philcuvin/UHN_N-ARM/UHN N-ARM Capstone Presentation Poster.pdf

Release force of 10 N

Supply 55 L/min flow

Aids in clearing of expiratory CO2

Restricts backflow, ±3% CO2 sensing resolution

Corrugated HEPA Filter

>99.97% filtration efficiency

200 ms response time

Sensor data processing

Up to 100 use cycles

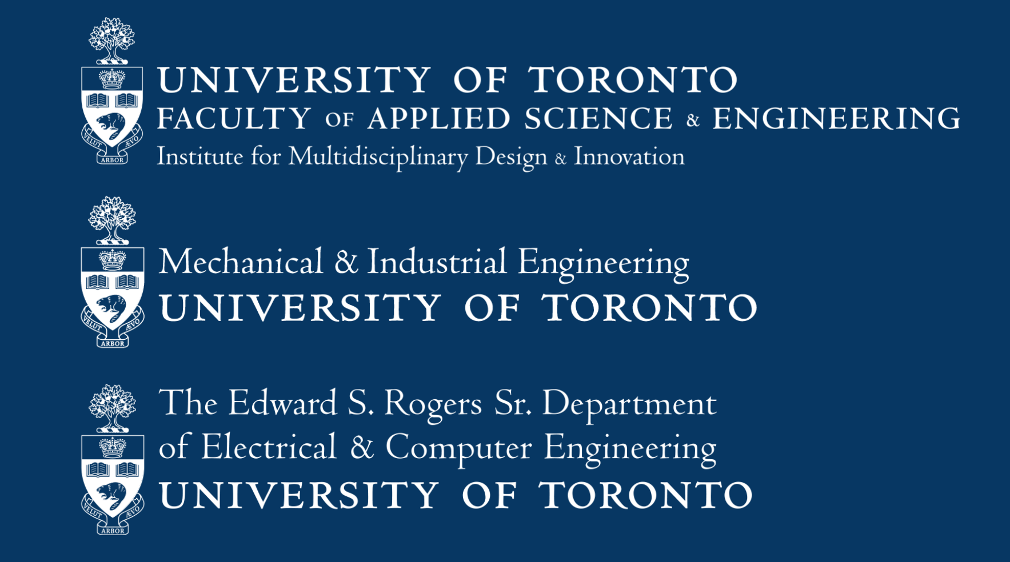
[picture p1: figure]

- Hydro-Guard Mini filter: 1.627 cmH2O at 36.481 L/min
- Simulation: PEEP of 6.258 cmH2O

[4, 5]

This project aims to design a low-cost, open-source, reusable non-invasive ventilation mask and alarm system for patients with respiratory infections.

# The Novel Aerosol-Reducing Mask: A Low-Cost Mask for Non-Invasive Ventilation

## Improvements & Impact References

Problem & Scope | Mask System Design | Testing & Results
- 3.686 cmH2O at 52.367 L/min [3]
- Incorporate a fan with higher static pressure [6]
- Enhanced sealing at the patient interface
- Reduction in size and mass of the electrical system

Resistance to Flow
< 5 cmH2O at
50 L/min

Filter Resistance
≥ 5 cmH2O PEEP at
30 L/min

Silicone Rubber Seal

40 N of sealing force

CO2
Rebreathing
ETCO2

Increase <
20% [3]

Leak Flow Rate
50 mL/min at
10 cmH2O

Polycarbonate Shell

One-Way Valve and CO2

Sensor Port

Noctua NF-A4x10 Fan

Anti-Asphyxia Valve

Release Mechanism

## Functions

Deliver air from CPAP machine to the patient and remove expiratory air without releasing infectious aerosols into the environment.

COVID-19:
Global shortage
of ventilators and
care staff [1, 2]

Spread of respiratory aerosols

CO2
build-up in existing masks

Expensive or single-use designs

N-ARM | CO2
accumulation

Continuous
Positive
Airway
Pressure
(CPAP)
- Percentage increase: -1.009%
- Fan assists in clearing out CO2 with
no supplied input flow
- 4 L/min with the majority of the leak from the patient-mask interface

Arduino Nano MCU

Control PCB

LED/Buzzer/Switch

Alarm Response
Time
< 10 seconds
- Less than 200 ms for all alarms
- Alarms trigger independently, can be individually toggled via switches
Hayley Yap | Phil Cuvin | Qianhan (Helen) Cui | Kimia Abedi | Jinglun (Clarence) Zhao

$$$

[1] M. Dar, L. Swamy, D. Gavin, and A. Theodore, “Mechanical-Ventilation Supply and Options for the COVID-19 Pandemic. Leveraging All Available Resources for a Limited Resource in a Crisis,” Annals of the American Thoracic Society, vol. 18, no. 3, pp. 408–416, Mar. 2021.
[2] F. Menzella, C. Barbieri, M. Fontana, C. Scelfo, C. Castagnetti, G. Ghidoni, P. Ruggiero, F. Livrieri, R. Piro, L. Ghidorsi, G. Montanari, G. Gibellini, E. Casalini, F. Falco, C. Catellani, and N. Facciolongo, “Effectiveness of noninvasive ventilation in COVID‐19 related‐acute respiratory distress syndrome,” The Clinical Respiratory Journal, vol. 15, no. 7, pp. 779–787, Jul. 2021.
[3] Medical devices — Sleep apnoea breathing therapy — Masks and application accessories, ISO 17510:2015, International Organization for Standardization, Aug. 1, 2015.
[4] D. E. White, “Breathing Therapy Air Delivery Unit: Simulation, Design and Development,” Thesis, 2003.
[5] E. Young. (2022). MIE458 22-12-02 Lecture 20 Kozeny Carman Edema [PDF document].
[6] M. I. Nazarious, T. Mathanlal, M.-P. Zorzano, and J. Martin-Torres, “Pressure Optimized PowEred Respirator (PROPER): A miniaturized wearable cleanroom and biosafety system for aerially transmitted viral infections such as COVID-19,” HardwareX, vol. 8, Oct. 2020.

Icon credits to: Flaticon. [Online]. Available: https://www.flaticon.com/.

Supervisor: Professor Kamran Behdinan | Client: Dr. Azad Mashari

Release infectious
aerosols

Input Port

Connects to CPAP
and flow sensor

The N-ARM design improves patient access to respiratory care and affords greater resilience and care capacity to Canadian health systems during respiratory virus outbreaks.

Block Diagram of System Integration

Input Flow
< 4 L/min

CO2

[%]
> 20%

Voltage
Supply < 5V
1. | 2. | 3.

Trigger a visible and audible alarm when any of the following conditions occur:

Prototype on
Headform

Input One-Way Valve

Restricts air backflow
