philcuvin/UHN_N-ARM/Case Assembly Final/Piezo Buzzer.SLDPRT

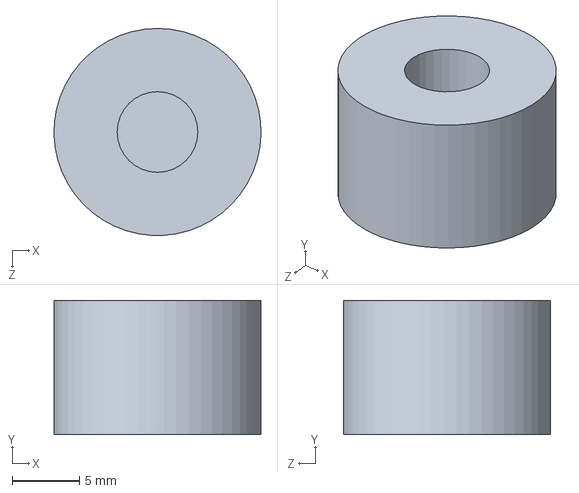
[picture p3: CAD file, 2023-04-19]
Case Assembly Final/Piezo Buzzer.SLDPRT
15.4 x 10.0 x 15.4 mm
