philcuvin/UHN_N-ARM/Case Assembly Final/Case Plug.SLDPRT

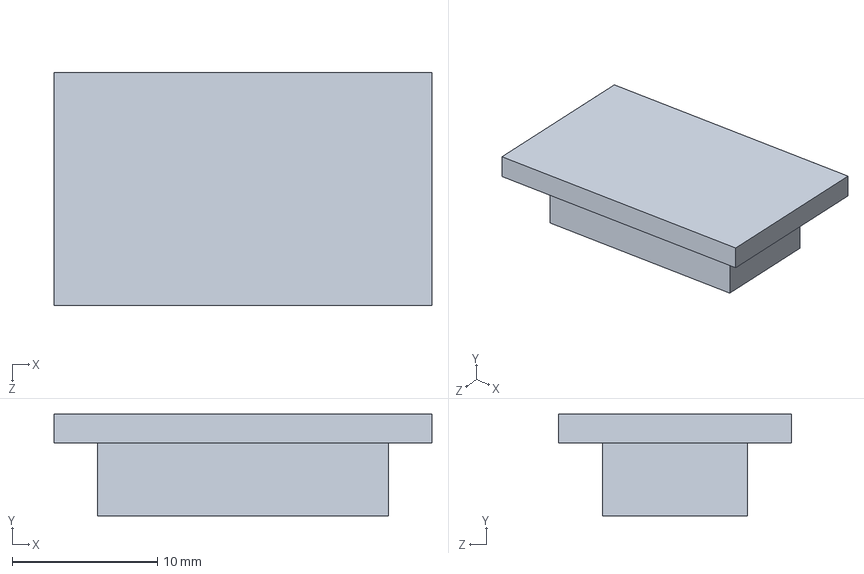
[picture p4: CAD file, 2023-04-19]
Case Assembly Final/Case Plug.SLDPRT
26.0 x 7.00 x 16.0 mm
