philcuvin/UHN_N-ARM/Case Assembly Final/Electronics Cover.SLDPRT

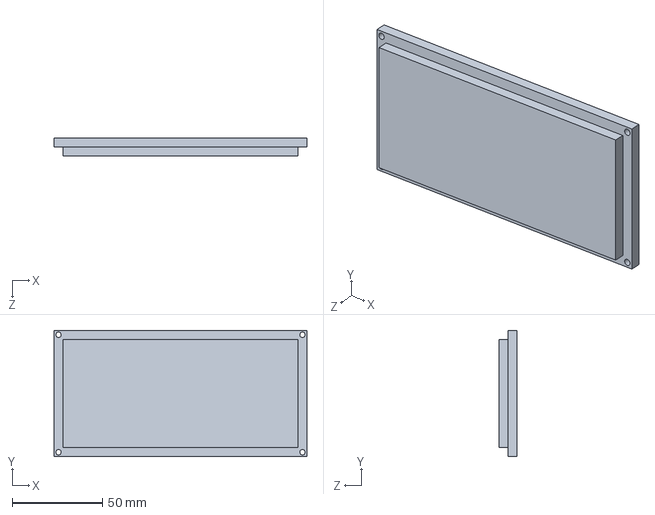
[picture p5: CAD file, 2023-04-19]
Case Assembly Final/Electronics Cover.SLDPRT
140.0 x 70.0 x 10.0 mm
