philcuvin/UHN_N-ARM/Case Assembly Final/Electronics Case.SLDPRT

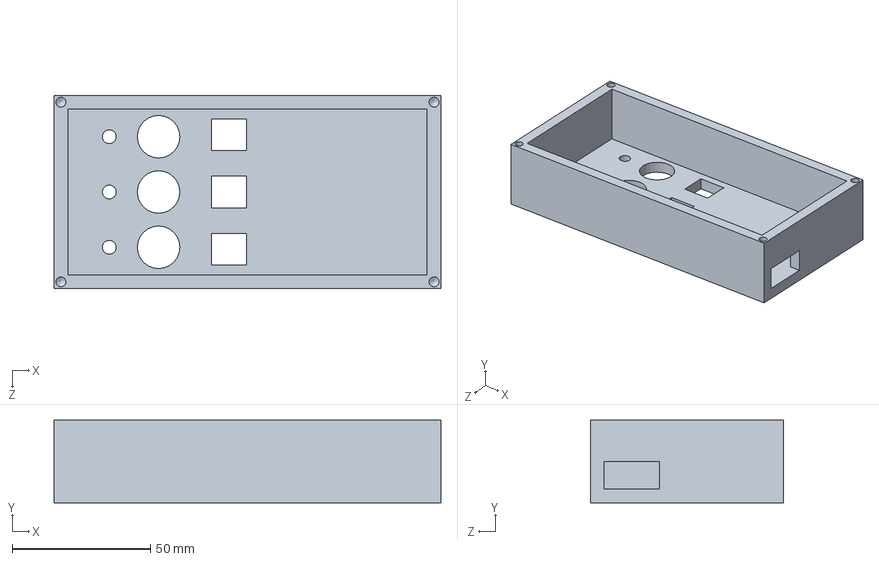
[picture p6: CAD file, 2023-04-19]
Case Assembly Final/Electronics Case.SLDPRT
140.0 x 30.0 x 70.0 mm
