philcuvin/UHN_N-ARM/Case Assembly Final/Case PCB.SLDPRT

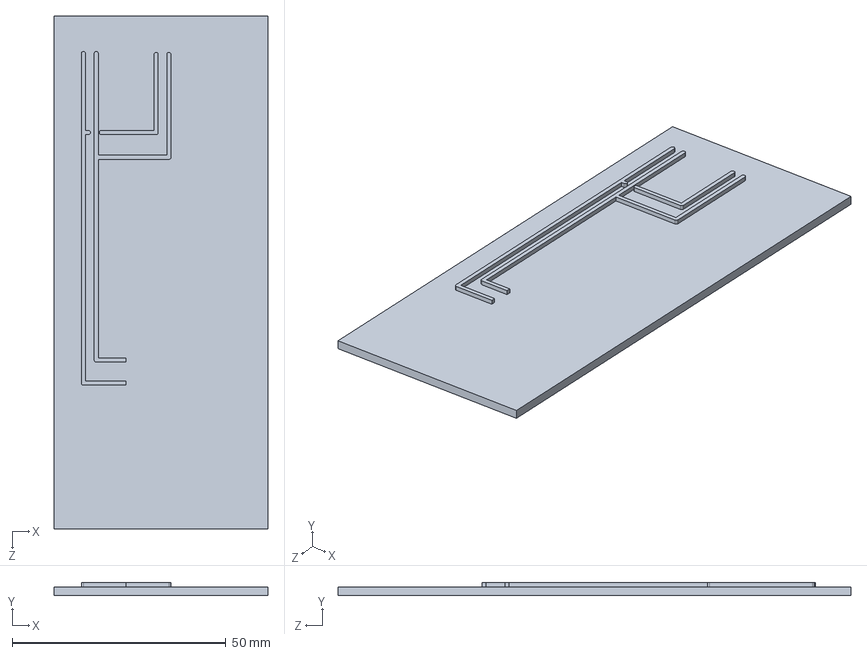
[picture p7: CAD file, 2023-04-19]
Case Assembly Final/Case PCB.SLDPRT
50.0 x 3.00 x 120.0 mm
