philcuvin/UHN_N-ARM/Case Assembly Final/LED.SLDPRT

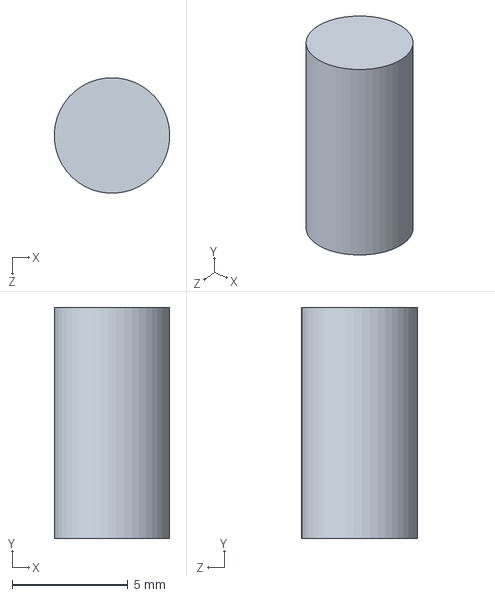
[picture p8: CAD file, 2023-04-19]
Case Assembly Final/LED.SLDPRT
5.00 x 10.0 x 5.00 mm
