philcuvin/UHN_N-ARM/Case Assembly Final/Electronics Buttons.SLDPRT

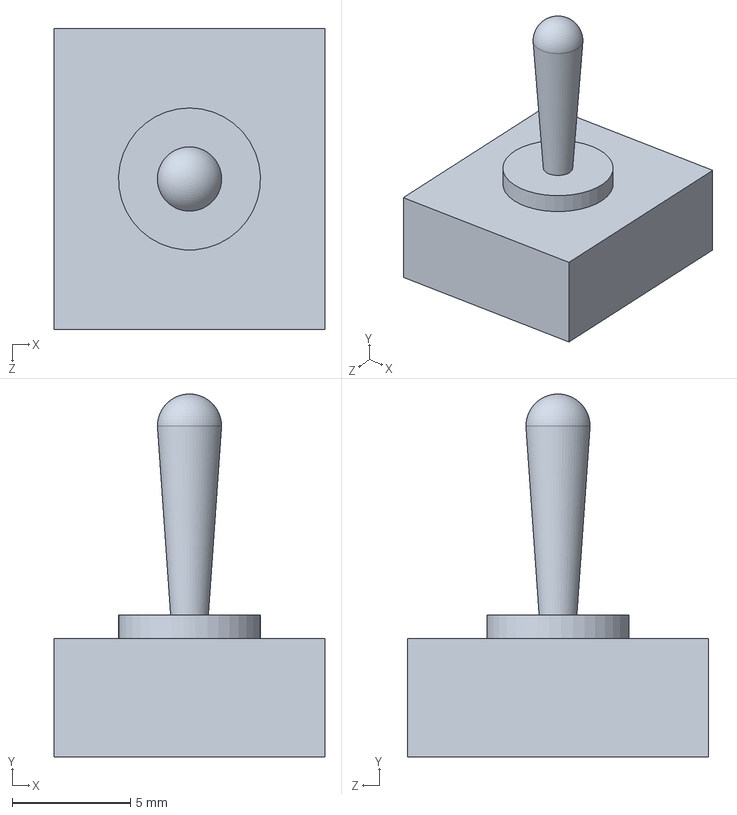
[picture p9: CAD file, 2023-04-19]
Case Assembly Final/Electronics Buttons.SLDPRT
11.4 x 15.3 x 12.7 mm
